apparentlymart/miniclock/parts.txt

RTC:
http://www.digikey.com/product-detail/en/DS3231MZ%2B/DS3231MZ%2B-ND/2754396

LPC812 Microcontroller:
http://www.digikey.com/product-detail/en/LPC812M101JD20FP/568-10435-5-ND/4368883

Right-angle header (for FTDI serial cable):
http://www.digikey.com/product-detail/en/0901210126/WM8100-ND/760815

Square 1.2" LED matrix:
http://www.adafruit.com/products/1819

LED Matrix Driver
http://www.digikey.com/product-detail/en/MAX6960AMH%2BD/MAX6960AMH%2BD-ND/1513156

3.3V voltage regulator
http://www.digikey.com/product-detail/en/LD1117S33TR/497-1242-1-ND/586242

6 Buttons:
http://www.digikey.com/product-detail/en/FSM4JSMATR/450-1759-2-ND/529675

UWX1V470MCL1GB capacitor:
http://www.digikey.com/product-detail/en/UWX1V470MCL1GB/493-2120-1-ND/590095

8MHz oscillator:
http://www.digikey.com/product-detail/en/SG-636PCE%208.0000MC0:ROHS/SER2815CT-ND/1532625
