apparentlymart/miniclock/displayboard/displayboard.kicad_pcb

## KiCad design displayboard/displayboard.kicad_pcb (2016-01-31)

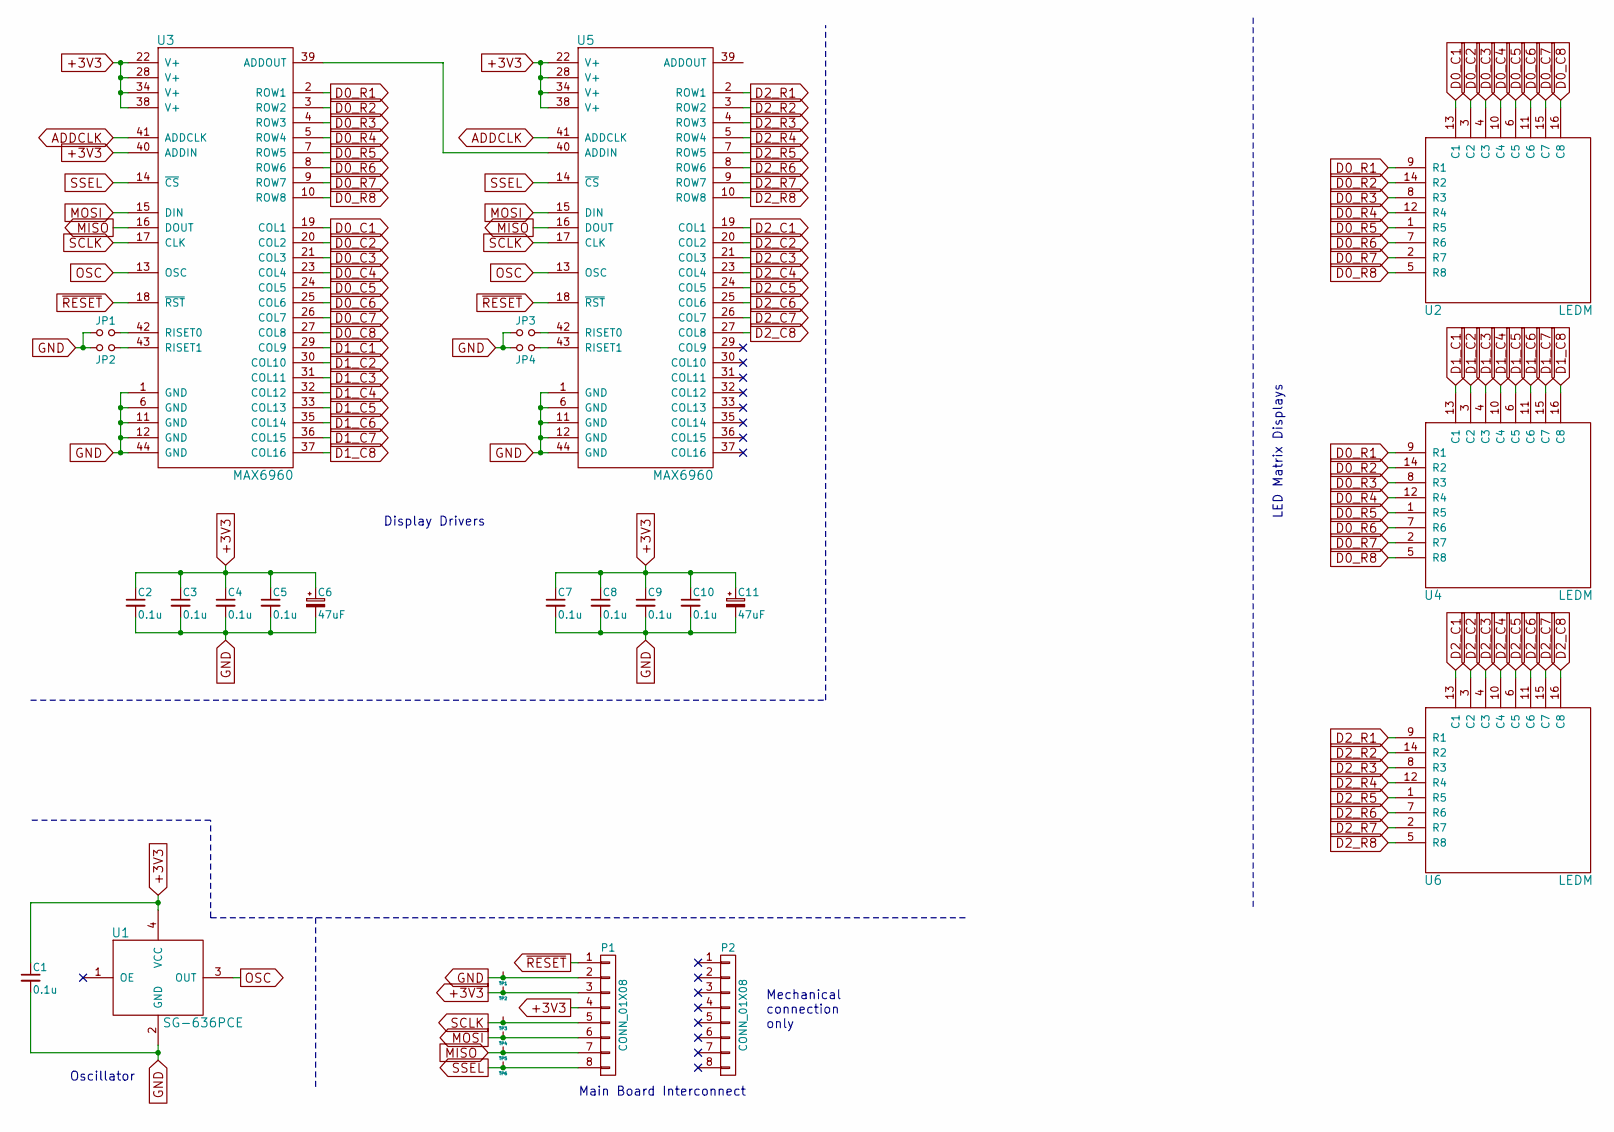
[picture p1: schematic displayboard.sch]

Parts:
C1, C2, C3, C4, C5, C7, C8, C9, C10: 0.1u; 0805
C6, C11: 47uF; UWX1V470MCL1GB
JP1, JP2, JP3, JP4: Jumper_NO_Small; 0805
P1, P2: CONN_01X08; Pin_Header_Straight_1x08
TP1, TP2, TP3, TP4, TP5, TP6: TESTPOINT
U1: SG-636PCE
U2, U4, U6: LEDM; KWM-R30881CUYB
U3, U5: MAX6960

Connections:
+3V3: C1.1, C2.1, C3.1, C4.1, C5.1, C6.1, C7.1, C8.1, C9.1, C10.1, C11.1, P1.3, P1.4, TP2.1, U1.4 (VCC), U3.22 (V+), U3.28 (V+), U3.34 (V+), U3.38 (V+), U3.40 (ADDIN), U5.22 (V+), U5.28 (V+), U5.34 (V+), U5.38 (V+)
ADDCLK: U3.41 (ADDCLK), U5.41 (ADDCLK)
D0_C1: U2.13 (C1), U3.19 (COL1)
D0_C2: U2.3 (C2), U3.20 (COL2)
D0_C3: U2.4 (C3), U3.21 (COL3)
D0_C4: U2.10 (C4), U3.23 (COL4)
D0_C5: U2.6 (C5), U3.24 (COL5)
D0_C6: U2.11 (C6), U3.25 (COL6)
D0_C7: U2.15 (C7), U3.26 (COL7)
D0_C8: U2.16 (C8), U3.27 (COL8)
D0_R1: U2.9 (R1), U3.2 (ROW1), U4.9 (R1)
D0_R2: U2.14 (R2), U3.3 (ROW2), U4.14 (R2)
D0_R3: U2.8 (R3), U3.4 (ROW3), U4.8 (R3)
D0_R4: U2.12 (R4), U3.5 (ROW4), U4.12 (R4)
D0_R5: U2.1 (R5), U3.7 (ROW5), U4.1 (R5)
D0_R6: U2.7 (R6), U3.8 (ROW6), U4.7 (R6)
D0_R7: U2.2 (R7), U3.9 (ROW7), U4.2 (R7)
D0_R8: U2.5 (R8), U3.10 (ROW8), U4.5 (R8)
D1_C1: U3.29 (COL9), U4.13 (C1)
D1_C2: U3.30 (COL10), U4.3 (C2)
D1_C3: U3.31 (COL11), U4.4 (C3)
D1_C4: U3.32 (COL12), U4.10 (C4)
D1_C5: U3.33 (COL13), U4.6 (C5)
D1_C6: U3.35 (COL14), U4.11 (C6)
D1_C7: U3.36 (COL15), U4.15 (C7)
D1_C8: U3.37 (COL16), U4.16 (C8)
D2_C1: U5.19 (COL1), U6.13 (C1)
D2_C2: U5.20 (COL2), U6.3 (C2)
D2_C3: U5.21 (COL3), U6.4 (C3)
D2_C4: U5.23 (COL4), U6.10 (C4)
D2_C5: U5.24 (COL5), U6.6 (C5)
D2_C6: U5.25 (COL6), U6.11 (C6)
D2_C7: U5.26 (COL7), U6.15 (C7)
D2_C8: U5.27 (COL8), U6.16 (C8)
D2_R1: U5.2 (ROW1), U6.9 (R1)
D2_R2: U5.3 (ROW2), U6.14 (R2)
D2_R3: U5.4 (ROW3), U6.8 (R3)
D2_R4: U5.5 (ROW4), U6.12 (R4)
D2_R5: U5.7 (ROW5), U6.1 (R5)
D2_R6: U5.8 (ROW6), U6.7 (R6)
D2_R7: U5.9 (ROW7), U6.2 (R7)
D2_R8: U5.10 (ROW8), U6.5 (R8)
GND: C1.2, C2.2, C3.2, C4.2, C5.2, C6.2, C7.2, C8.2, C9.2, C10.2, C11.2, JP1.1, JP2.2, JP3.1, JP4.2, P1.2, TP1.1, U1.2 (GND), U3.1 (GND), U3.6 (GND), U3.11 (GND), U3.12 (GND), U3.44 (GND), U5.1 (GND), U5.6 (GND), U5.11 (GND), U5.12 (GND), U5.44 (GND)
MISO: P1.7, TP5.1, U3.16 (DOUT), U5.16 (DOUT)
MOSI: P1.6, TP4.1, U3.15 (DIN), U5.15 (DIN)
unnamed: JP1.2, U3.42 (RISET0)
unnamed: JP2.1, U3.43 (RISET1)
unnamed: JP3.2, U5.42 (RISET0)
unnamed: JP4.1, U5.43 (RISET1)
unnamed: U3.39 (ADDOUT), U5.40 (ADDIN)
OSC: U1.3 (OUT), U3.13 (OSC), U5.13 (OSC)
SCLK: P1.5, TP3.1, U3.17 (CLK), U5.17 (CLK)
SSEL: P1.8, TP6.1, U3.14 (~CS), U5.14 (~CS)
~RESET: P1.1, U3.18 (~RST), U5.18 (~RST)

Notes on the sheet:
Mechanical connection only
Main Board Interconnect
Oscillator
LED Matrix Displays
Display Drivers

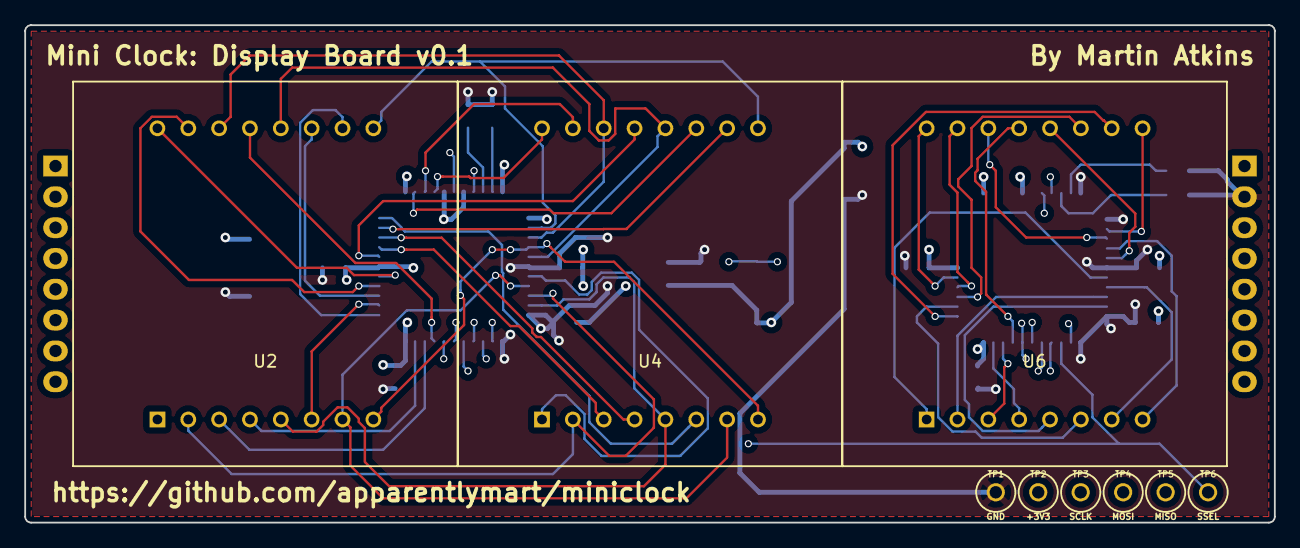
[picture p2: board displayboard.kicad_pcb from above]

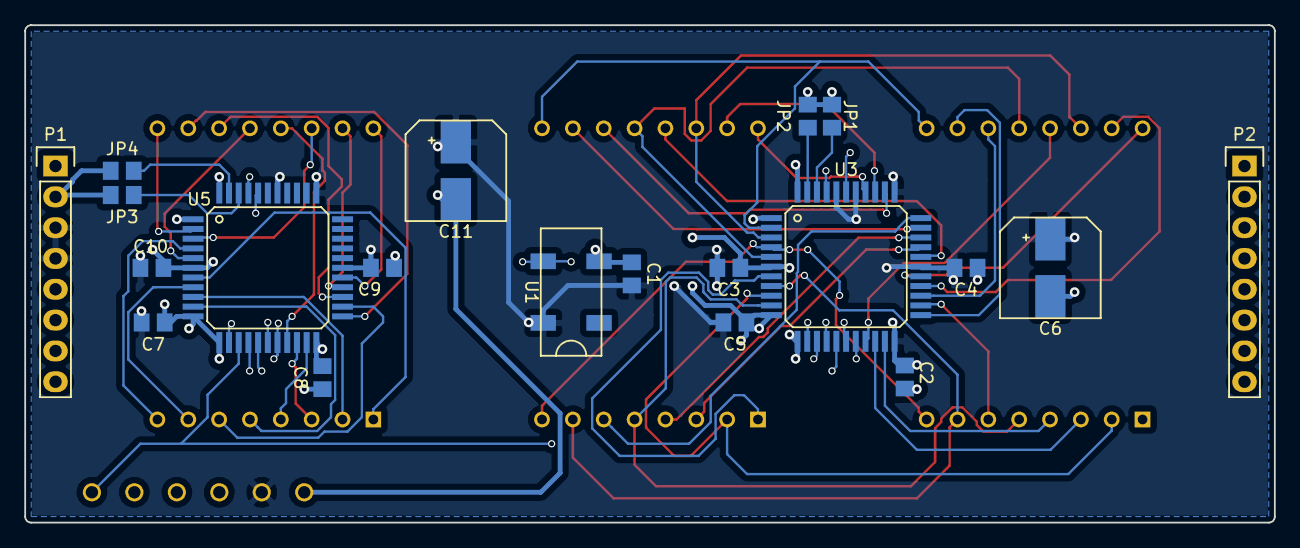
[picture p3: board displayboard.kicad_pcb from below]

Board: 4 copper layers, 103.0 x 41.0 mm, 29 parts (20 on the bottom side), 54 nets.
