apparentlymart/miniclock/mainboard/mainboard.kicad_pcb

## KiCad design mainboard/mainboard.kicad_pcb (2015-09-11)

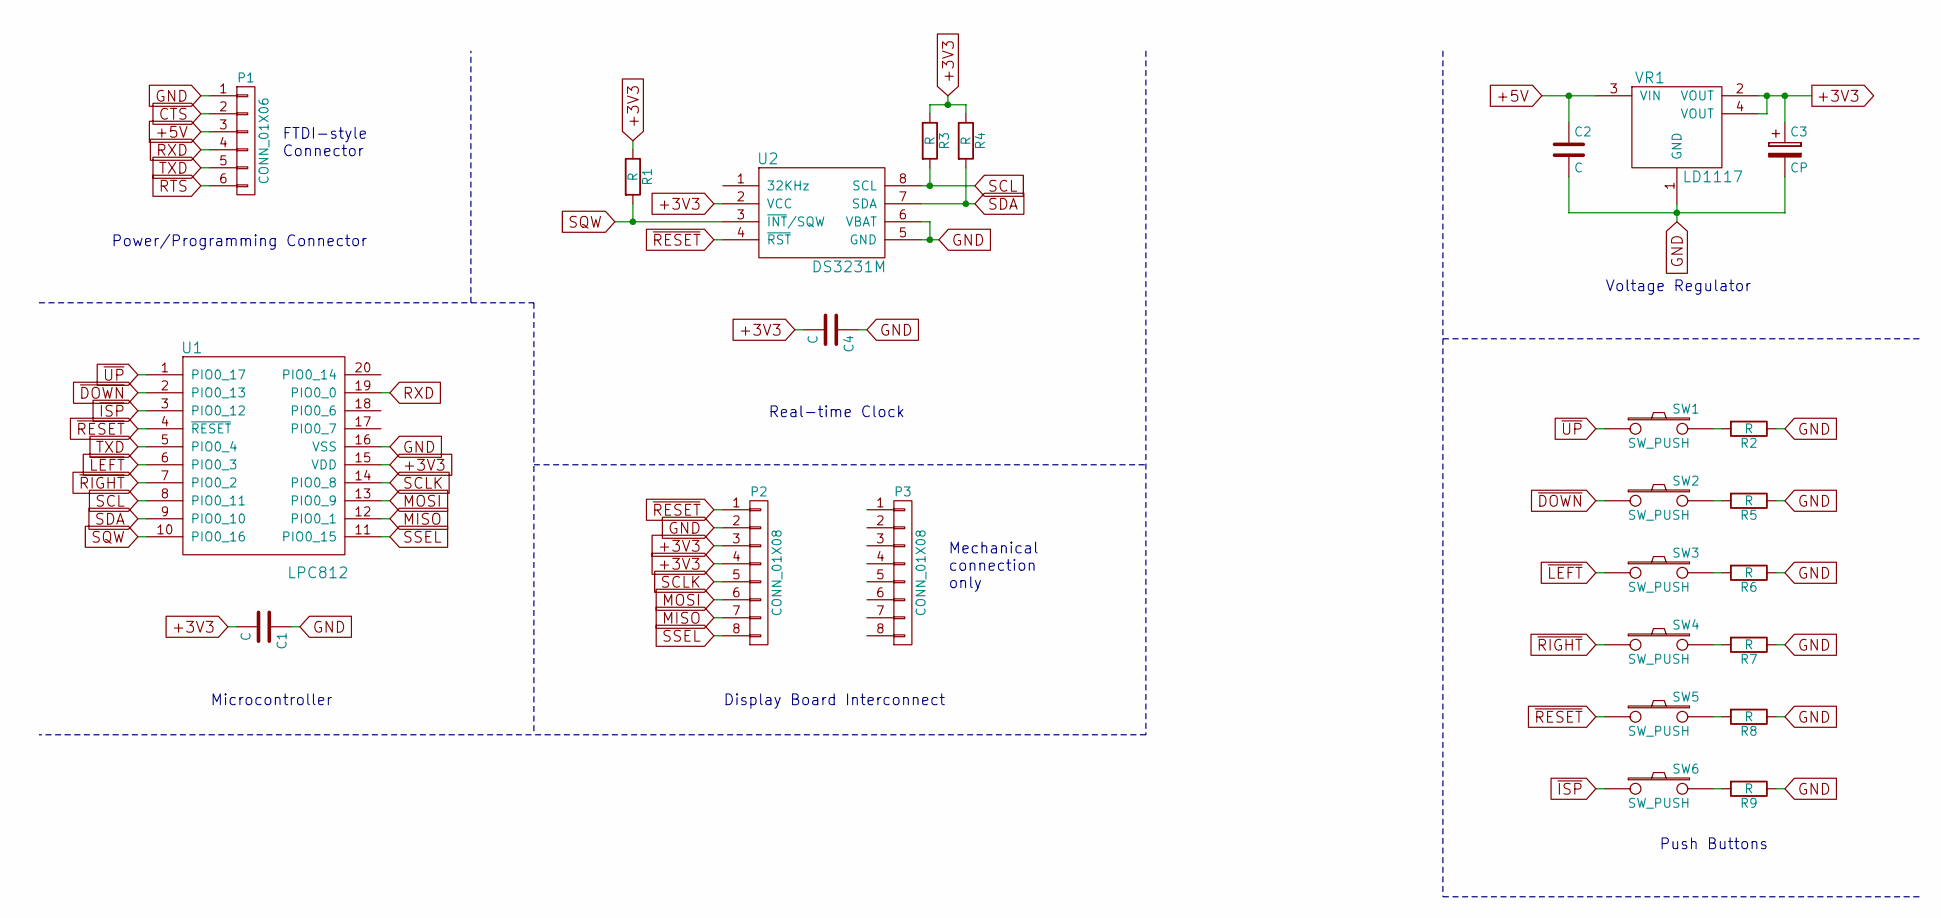
[picture p4: schematic mainboard.sch]

Parts:
C1, C2, C4: C; C_0805_HandSoldering
C3: CP; CPOL_SMD_6.3mm
P1: CONN_01X06; Pin_Header_Straight_1x06
P2, P3: CONN_01X08; Pin_Header_Straight_1x08
R1, R2, R3, R4, R5, R6, R7, R8, R9: R; R_0805_HandSoldering
SW1, SW2, SW3, SW4, SW5, SW6: SW_PUSH; PUSHSWITCH
U1: LPC812; SOIC-20_7.5x12.8mm_Pitch1.27mm
U2: DS3231M; SOIC-8_3.9x4.9mm_Pitch1.27mm
VR1: LD1117; SOT223

Connections:
+3V3: C1.2, C3.1, C4.2, P2.3, P2.4, R1.1, R3.1, R4.1, U1.15 (VDD), U2.2 (VCC), VR1.2 (VOUT), VR1.4 (VOUT)
+5V: C2.1, P1.3, VR1.3 (VIN)
CTS: P1.2
GND: C1.1, C2.2, C3.2, C4.1, P1.1, P2.2, R2.1, R5.1, R6.1, R7.1, R8.1, R9.1, U1.16 (VSS), U2.5 (GND), U2.6 (VBAT), VR1.1 (GND)
MISO: P2.7, U1.12 (PIO0_1)
MOSI: P2.6, U1.13 (PIO0_9)
unnamed: R2.2, SW1.2
unnamed: R5.2, SW2.2
unnamed: R6.2, SW3.2
unnamed: R7.2, SW4.2
unnamed: R8.2, SW5.2
unnamed: R9.2, SW6.2
RTS: P1.6
RXD: P1.4, U1.19 (PIO0_0)
SCL: R3.2, U1.8 (PIO0_11), U2.8 (SCL)
SCLK: P2.5, U1.14 (PIO0_8)
SDA: R4.2, U1.9 (PIO0_10), U2.7 (SDA)
SQW: R1.2, U1.10 (PIO0_16), U2.3 (~INT~/SQW)
SSEL: P2.8, U1.11 (PIO0_15)
TXD: P1.5, U1.5 (PIO0_4)
~DOWN: SW2.1, U1.2 (PIO0_13)
~ISP: SW6.1, U1.3 (PIO0_12)
~LEFT: SW3.1, U1.6 (PIO0_3)
~RESET: P2.1, SW5.1, U1.4 (~RESET), U2.4 (~RST)
~RIGHT: SW4.1, U1.7 (PIO0_2)
~UP: SW1.1, U1.1 (PIO0_17)

Notes on the sheet:
FTDI-style Connector
Microcontroller
Real-time Clock
Voltage Regulator
Power/Programming Connector
Mechanical connection only
Display Board Interconnect
Push Buttons

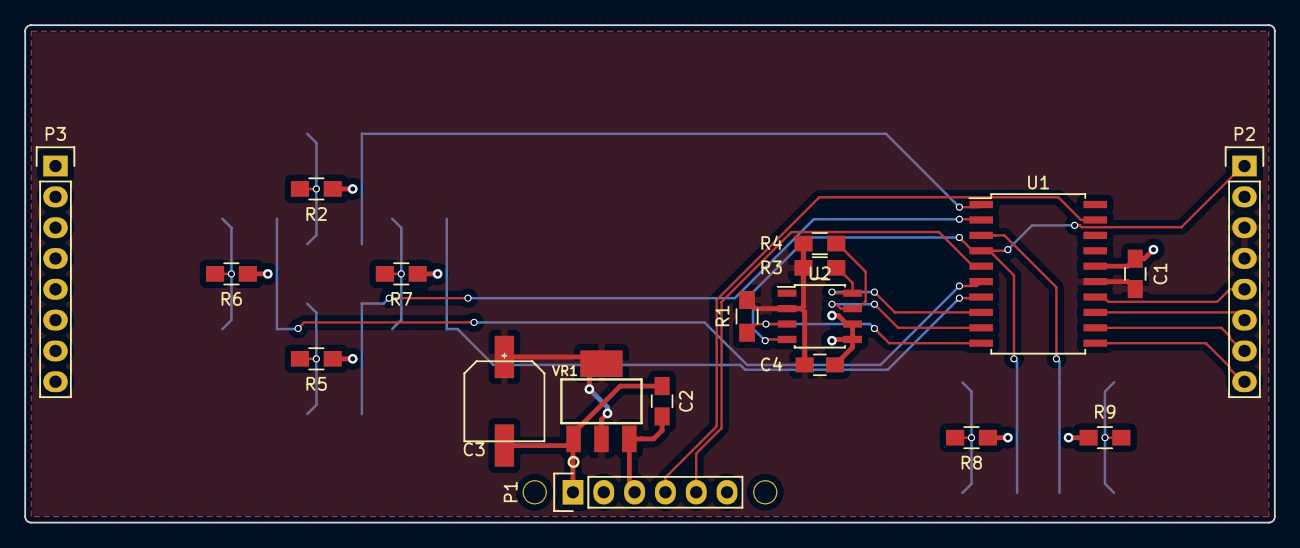
[picture p5: board mainboard.kicad_pcb from above]

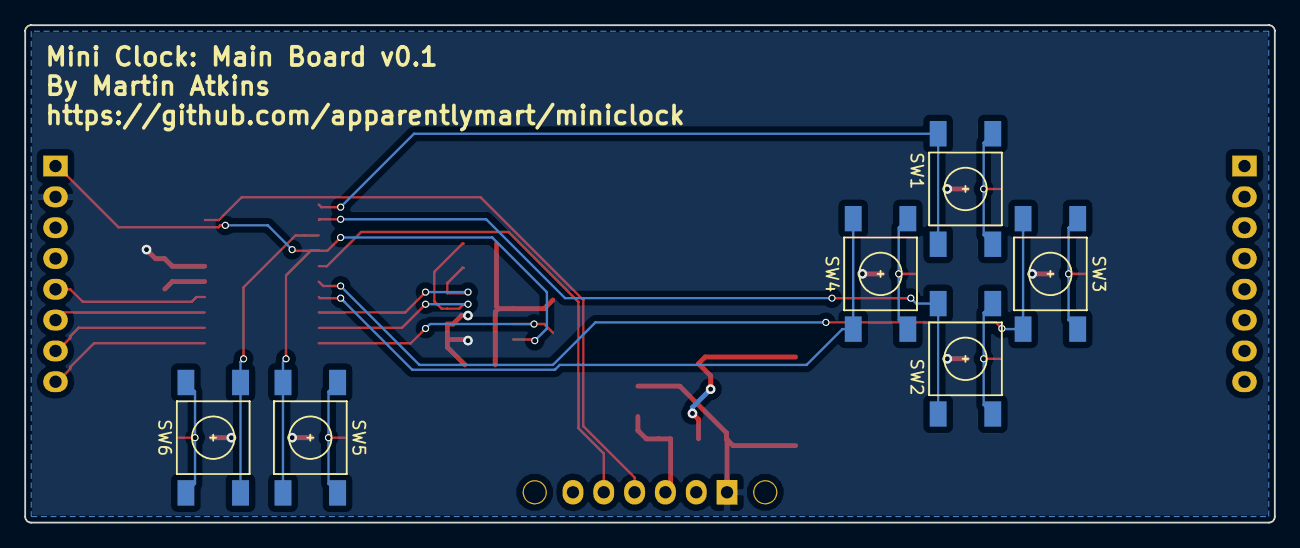
[picture p6: board mainboard.kicad_pcb from below]

Board: 2 copper layers, 103.0 x 41.0 mm, 25 parts (6 on the bottom side), 24 nets.
