apparentlymart/miniclock/firmware/display.c

#include "scheduler.h"
#include "serial.h"
#include "buttons.h"
#include "ui.h"
#include "digits.h"
#include "display_states.h"
#include "clock.h"
#include "spi.h"
#include "display.h"

int anim_active = 0;
sched_list_head transition_tasks;
sched_task *active_transition_task = 0;

// During animation, the first index of this array points to either
// the topmost or the leftmost state, depending on which direction we're
// animating in, with the second index pointing to the bottom or right
// state. When we're not showing two states on-screen, only the first
// index is significant.
ui_state display_states[2] = {UI_BEGIN, UI_BEGIN};
char offset_amt;
char offset_target;
unsigned char offset_dir = 'h';

sched_task anim_dispatch_task;
sched_task anim_task;
void *anim_task_pos;

sched_task time_change_task;

static inline void display_render_row(unsigned char data) {
    spi_tx_8(data);
}

void display_render_horiz(void) {
    // For Horiz, we visit rows in the first state first,
    // and then rows in the second state, until we've
    // filled the screen.
    int elem_row = 0;
    int state_row = 0;
    int screen_row = 0;
    int state_idx = 0;
    int skipped_rows = 0;

    // Reset the display data offset to the beginning of memory
    spi_tx_16(0x09 << 8);
    spi_tx_16(0x0a << 8);

    display_elem *elems = display_elems_for_state(display_states[0]);
    while (1) {
        if (state_row == 24 || screen_row == 24 || ! elems->impl) {
            // If we're still on the first state, we must complete it
            // with blank rows before moving on to the second state.
            if (state_idx == 0) {
                while (state_row < 24 && screen_row < 24) {
                    display_render_row(0);
                    state_row++;
                    screen_row++;
                }
                if (screen_row < 24) {
                    state_idx++;
                    state_row = 0;
                    elems = display_elems_for_state(display_states[1]);
                }
                else {
                    break;
                }
            }
            else {
                // If we're already on the second state then we'll
                // just complete the screen and then we're done.
                while (screen_row < 24) {
                    display_render_row(0);
                    screen_row++;
                }
                break;
            }
        }
        const unsigned char *data_p = elems->impl(elems->arg, elem_row);
        if (! data_p) {
            elem_row = 0;
            elems++;
            continue;
        }

        if (skipped_rows < offset_amt) {
            elem_row++;
            state_row++;
            skipped_rows++;
            // but not screen_row, because we didn't actually
            // render anything.
            continue;
        }

        if (elems->blink && clock_time.half_second) {
            // For blinking elements, render blank if we're in
            // the second half of a second.
            display_render_row(0b00000000);
        }
        else {
            display_render_row(*data_p);
        }

        elem_row++;
        screen_row++;
        state_row++;
    }
}

void display_render_vert(void) {
    // For vert, we visit both states concurrently and then shift their
    // pixel data about to make them render one on top of the other.

    // Reset the display data offset to the beginning of memory
    spi_tx_16(0x09 << 8);
    spi_tx_16(0x0a << 8);

    // Keep track of where we are in the elems of both states.
    int elem_rows[2] = {0, 0};
    display_elem *elems[2] = {
        display_elems_for_state(display_states[0]),
        display_elems_for_state(display_states[1]),
    };
    unsigned char data[2] = {0, 0};

    for (int screen_row = 0; screen_row < 24; screen_row++) {
        for (int state_idx = 0; state_idx < 2; state_idx++) {
            while (1) {
                if (elems[state_idx]->impl) {
                    const unsigned char *data_p = elems[state_idx]->impl(
                        elems[state_idx]->arg, elem_rows[state_idx]
                    );

                    if (data_p) {
                        if (elems[state_idx]->blink && clock_time.half_second) {
                            // For blinking elements, render blank if we're in
                            // the second half of a second.
                            data[state_idx] = 0b00000000;
                        }
                        else {
                            data[state_idx] = *data_p;
                        }
                        elem_rows[state_idx]++;
                        break;
                    }

                    // Try the next element, then.
                    elem_rows[state_idx] = 0;
                    elems[state_idx]++;
                }
                else {
                    // We ran out of elements for this state, so
                    // we'll just fill the rest of the screen with
                    // blanks.
                    data[state_idx] = 0b00000000;
                    break;
                }
            }
        }
        unsigned char merged_data = (
            data[0] >> offset_amt |
            data[1] << (8 - offset_amt)
        );
        display_render_row(merged_data);
    }

}

inline void display_render(void) {
    switch (offset_dir) {
    case 'h':
        display_render_horiz();
        break;
    case 'v':
        display_render_vert();
        break;
    default:
        uart_println("Invalid offset direction");
    }
}

void anim_offset_task(void) {
    TASK_START_EXT(anim_task, anim_task_pos);

    while (1) {
        display_render();
        TASK_AWAIT_EXT_RAW(anim_task_pos, task_sleep(&anim_task, 10));
        if (offset_target < offset_amt) {
            offset_amt--;
        }
        else if (offset_target > offset_amt) {
            offset_amt++;
        }
        if (offset_target == offset_amt) {
            break;
        }
    }

    // Always end in a consistent state.
    offset_amt = 0;
    offset_dir = 'h';
    // If we were moving away from zero then we actually want
    // to land on the second state, so we need to swap them now.
    if (offset_target != 0) {
        display_states[0] = display_states[1];
        offset_target = 0;
    }
    display_render();

    sched_dequeue_task(&anim_task);
    sched_run_task(&anim_dispatch_task);
}

void anim_elastic_space_task(void) {
    TASK_START_EXT(anim_task, anim_task_pos);

    while (1) {
        display_render();
        TASK_AWAIT_EXT_RAW(anim_task_pos, task_sleep(&anim_task, 10));
        if (offset_target < display_elastic_space_size) {
            display_elastic_space_size--;
        }
        else if (offset_target > display_elastic_space_size) {
            display_elastic_space_size++;
        }
        if (offset_target == display_elastic_space_size) {
            break;
        }
    }

    // Always end in a consistent state.
    display_elastic_space_size = 0;
    // If we were moving away from zero then we actually want
    // to land on the second state, so we need to swap them now.
    if (offset_target != 0) {
        display_states[0] = display_states[1];
        offset_target = 0;
    }
    display_render();

    sched_dequeue_task(&anim_task);
    sched_run_task(&anim_dispatch_task);
}

void anim_dispatch_task_impl(void) {

    // This task impl expects to be called only when either there is no
    // active transition, or when the transition is over. We distinguish
    // these cases by whether active_transition_task is set.
    if (active_transition_task) {
        // The transition is complete, so we'll schedule the task
        // to be run on the next loop iteration.
        sched_run_task(active_transition_task);
        active_transition_task = 0;
    }

    // Is there a new transition waiting in the queue?
    if (transition_tasks.next != &transition_tasks) {
        sched_task *task = (sched_task*)transition_tasks.next;
        display_transition_task *trans_task = (display_transition_task*)task;
        // Take the task out of the pending queue.
        sched_dequeue_task(task);
        active_transition_task = task;

        if (trans_task->old_state >= UI_SET_HOUR && trans_task->new_state >= UI_SET_HOUR) {
            // If we're transitioning between the states for setting different
            // components of the time then we won't animate at all, since
            // we're just moving the selection between on-screen elements.
            offset_dir = 'h';
            offset_amt = 0;
            offset_target = 0;
            display_states[0] = trans_task->new_state;
            display_states[1] = trans_task->new_state;
            anim_task.impl = anim_offset_task;
        }
        else if (trans_task->old_state == UI_TIME_HM && trans_task->new_state == UI_TIME_MS) {
            display_elastic_space_size = 12;
            offset_target = 0;
            display_states[0] = trans_task->new_state;
            display_states[1] = trans_task->new_state;
            anim_task.impl = anim_elastic_space_task;
        }
        else if (trans_task->old_state == UI_TIME_MS && trans_task->new_state == UI_TIME_HM) {
            display_elastic_space_size = 0;
            offset_target = 12;
            display_states[0] = trans_task->old_state;
            display_states[1] = trans_task->new_state;
            anim_task.impl = anim_elastic_space_task;
        }
        else if (trans_task->buttons == BUTTON_RIGHT) {
            offset_dir = 'h';
            offset_amt = 22;
            offset_target = 0;
            display_states[0] = trans_task->new_state;
            display_states[1] = trans_task->old_state;
            anim_task.impl = anim_offset_task;
        }
        else if (trans_task->buttons == BUTTON_LEFT) {
            offset_dir = 'h';
            offset_amt = 0;
            offset_target = 23;
            display_states[0] = trans_task->old_state;
            display_states[1] = trans_task->new_state;
            anim_task.impl = anim_offset_task;
        }
        else if (trans_task->buttons == BUTTON_UP) {
            offset_dir = 'v';
            offset_amt = 0;
            offset_target = 7;
            display_states[0] = trans_task->old_state;
            display_states[1] = trans_task->new_state;
            anim_task.impl = anim_offset_task;
        }
        else if (trans_task->buttons == BUTTON_DOWN) {
            offset_dir = 'v';
            offset_amt = 7;
            offset_target = 0;
            display_states[0] = trans_task->new_state;
            display_states[1] = trans_task->old_state;
            anim_task.impl = anim_offset_task;
        }
        else {
            // By default we'll use the anim_offset_task but give
            // it no work to do, so we'll just instantly transition
            // to the new state. This should never happen in practice
            // since one of the above rules should always apply.
            offset_dir = 'h';
            offset_amt = 0;
            offset_target = 0;
            display_states[0] = trans_task->new_state;
            display_states[1] = trans_task->new_state;
            anim_task.impl = anim_offset_task;
        }

        anim_task_pos = 0;
        // Call the task implementation to let it initialize
        // and schedule itself.
        anim_task.impl();
    }
    else {
        // No longer any animations active.
        anim_active = 0;
    }

    // Always dequeue after a run. If we started an animation above
    // then it will queue us back again when it ends, so we'll get
    // an opportunity to start a new animation.
    sched_dequeue_task(&anim_dispatch_task);
}

static void time_change_task_impl(void) {
    TASK_START(time_change_task_impl);

    while (1) {
        CLOCK_AWAIT_CHANGE();
        display_render();
    }
}

void display_init(void) {
    spi_init();

    // Initialize the display
    spi_tx_16(
        (0x0e << 8) | // "Global Driver Devices" register
        1             // 2 devices (1 "extra" device)
    );
    spi_tx_16(
        (0x0f << 8) | // "Global Driver Rows" register
        0             // 1 row (0 "extra" rows)
    );
    spi_tx_16(
        (0x0d << 8) | // "Global Panel Configuration" register
        1             // Disable shutdown mode
    );

    sched_init_task_head(&transition_tasks);
    sched_init_task(&anim_dispatch_task, anim_dispatch_task_impl);
    sched_init_task(&time_change_task, time_change_task_impl);

    // The anim task's implementation will be assigned by the
    // dispatch task, once it decides what kind of animation to use.
    sched_init_task(&anim_task, 0);

    // Immediately schedule our "time change task" so we'll get notified
    // each time the time changes. (every half-second)
    time_change_task_impl();
}

void display_state_change(
    sched_task *task,
    ui_state new_state,
    ui_state old_state,
    button buttons
) {
    display_transition_task *trans_task = (display_transition_task*)task;
    trans_task->new_state = new_state;
    trans_task->old_state = old_state;
    trans_task->buttons = buttons;

    sched_queue_task(&transition_tasks, task);

    if (! anim_active) {
        anim_active = 1;
        sched_run_task(&anim_dispatch_task);
    }
}
