apparentlymart/miniclock/firmware/chars.c

#include "chars.h"

const unsigned char tom_thumb_tall[][4] = {
    { // 32
        0b00000000,
        0b00000000,
        0b00000000,
        0b00000000,
    },
    { // 33 !
        0b00000000,
        0b01011111,
        0b00000000,
        0b00000000,
    },
    { // 34 "
        0b00000011,
        0b00000000,
        0b00000011,
        0b00000000,
    },
    { // 35 #
        0b00111110,
        0b00010100,
        0b00111110,
        0b00000000,
    },
    { // 36 $
        0b00101000,
        0b01111110,
        0b00010100,
        0b00000000,
    },
    { // 37 %
        0b01100001,
        0b00011100,
        0b01000011,
        0b00000000,
    },
    { // 38 &
        0b00111110,
        0b01011110,
        0b01110000,
        0b00000000,
    },
    { // 39 '
        0b00000000,
        0b00000011,
        0b00000000,
        0b00000000,
    },
    { // 40 (
        0b00000000,
        0b01111110,
        0b10000001,
        0b00000000,
    },
    { // 41 )
        0b10000001,
        0b01111110,
        0b00000000,
        0b00000000,
    },
    { // 42 *
        0b00010101,
        0b00001110,
        0b00010101,
        0b00000000,
    },
    { // 43 +
        0b00001000,
        0b00011100,
        0b00001000,
        0b00000000,
    },
    { // 44 ,
        0b10000000,
        0b01000000,
        0b00000000,
        0b00000000,
    },
    { // 45 -
        0b00001000,
        0b00001000,
        0b00001000,
        0b00000000,
    },
    { // 46 .
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
        0b00111000,
        0b01000000,
        0b01111000,
        0b00000000,
    },
    { // 118 v
        0b00111000,
        0b01000000,
        0b00111000,
        0b00000000,
    },
    { // 119 w
        0b01111000,
        0b01110000,
        0b01111000,
        0b00000000,
    },
    { // 120 x
        0b01001000,
        0b00110000,
        0b01001000,
        0b00000000,
    },
    { // 121 y
        0b00011000,
        0b10100000,
        0b01111000,
        0b00000000,
    },
    { // 122 z
        0b01101000,
        0b01111000,
        0b01011000,
        0b00000000,
    },
    { // 123 {
        0b00011000,
        0b11100111,
        0b10000001,
        0b00000000,
    },
    { // 124 |
        0b00000000,
        0b01110111,
        0b00000000,
        0b00000000,
    },
    { // 125 }
        0b10000001,
        0b11100111,
        0b00011000,
        0b00000000,
    },
    { // 126 ~
        0b00000010,
        0b00000011,
        0b00000001,
        0b00000000,
    }
};


const unsigned char* chars_row(int val, int row) {
    if (val < 32 || val > 126) {
        return 0;
    }
    val -= 32;
    return row < 4 ? ((const char *)tom_thumb_tall + (val * 4) + row) : 0;
}
