apparentlymart/miniclock/firmware/serial.c

#include <stdint.h>
#include "lpc812.h"
#include "serial.h"

static uart_buffer rx_buffer;

void UART0_isr(void);

void uart_init() {
    // Put the UART in reset mode.
    SYSCON_PRESETCTRL &= ~BIT3;

    rx_buffer.count = 0;
    rx_buffer.head = 0;
    rx_buffer.tail = 0;

    // Enable USART0 clock
    SYSCON_SYSAHBCLKCTRL |= BIT14;

    // Take the UART out of reset mode,
    SYSCON_PRESETCTRL |= BIT3;

    // Disable UART0 while we configure it.
    USART0_CFG = 0;

    // Enable USART0 IRQs
    NVIC_ISER0 |= BIT3;

    // Map the USART0 pins to match the ISP pins.
    PINENABLE0 |= BIT0;
    PINASSIGN0 &= 0xffff0000;
    PINASSIGN0 |= 4; // TXD on PIO0_4
    PINASSIGN0 |= 0; // RXD on PIO0_0

    // 115200 baud
    SYSCON_UARTCLKDIV = 1;
    USART0_BRG = 31;

    SYSCON_UARTFRGDIV = 0xff;
    SYSCON_UARTFRGMULT = 4;

    // Enable RX interrupt
    USART0_INTENSET = BIT0;
    USART0_CTL = 0;

    // 8 data bits, 1 stop bit, no parity bit
    USART0_CFG = 0b00000101;
}

void UART0_isr(void) {
    int source = USART0_INTSTAT;
    // If it's the RX interrupt
    if (source & BIT0) {
        uart_buffer_put(&rx_buffer, USART0_RXDAT);
    }
}

void uart_buffer_put(uart_buffer *sbuf, char c) {
    if (sbuf->count < SBUFSIZE) {
        disable_interrupts();
        sbuf->count++;
        sbuf->buffer[sbuf->head] = c;
        sbuf->head = (sbuf->head + 1) % SBUFSIZE;
        enable_interrupts();
    }
}

char uart_buffer_get(uart_buffer *sbuf) {
    char c = 0;
    if (sbuf->count >0 ) {
        disable_interrupts();
        sbuf->count--;
        c = sbuf->buffer[sbuf->tail];
        sbuf->tail = (sbuf->tail+1) % SBUFSIZE;
        enable_interrupts();
    }
    return c;
}

int uart_rx_buffer_count() {
    return rx_buffer.count;
}

void uart_putc(char c) {
    // Poll for the transmitter to become ready
    while ((USART0_STAT & (0x1 << 2)) == 0);

    USART0_TXDAT = c;

    // Poll for the transmitter to return to idle
    while ((USART0_STAT & (0x1 << 3)) == 0);
}

void uart_puts(const char *s) {
    for (; *s; s++) {
        uart_putc(*s);
    }
}

void uart_put_int_hex(unsigned int val) {
    for (int i = 0; i < 8; i++) {
        // Read the top nybble.
        int digit = val >> 28;

        char c;
        if (digit < 0xa) {
            c = '0' + digit;
        }
        else {
            c = ('a' - 0xa) + digit;
        }

        uart_putc(c);

        // Push everything up one nybble.
        val <<= 4;
    }
}

char uart_getc() {
    return uart_buffer_get(&rx_buffer);
}

void uart_println(const char *s) {
    uart_puts(s);
    uart_puts("\r\n");
}

void uart_println_int_hex(const char *s, unsigned int val) {
    uart_puts(s);
    uart_put_int_hex(val);
    uart_puts("\r\n");
}
