apparentlymart/miniclock/(commit log)

2015-02-23 Sketch BOM
2015-02-28 KiCAD project.
2015-02-28 Initial import of schematic, with voltage regulator.
    [diyalarmclock.sch]
2015-02-28 Basic wiring for MCU and RTC.
    Still need to add capacitors to the power inputs.
    [diyalarmclock.sch]
2015-03-28 Start of schematic for the main control board.
    [miniclockmainboard.sch]
2015-03-28 Further work on the main board schematic.
    [miniclockmainboard.sch]
2015-03-28 Add RTC chip, I2C/SPI headers and support bits.
    [miniclockmainboard.sch]
2015-03-28 Complete first rev of the main board schematic.
    [miniclockmainboard.sch]
2015-03-28 Some PCB footprints for the main board.
2015-03-28 Schematic to footprint mappings.
2015-03-28 Main board PCB layout.
    [miniclockmainboard.kicad_pcb]
2015-03-28 Add some silkscreen captions to the rear of the main board.
    [miniclockmainboard.kicad_pcb]
2015-03-29 Shrink the main board width.
    Previous version was slightly too wide for the first prototype's
    enclosure. The new size is much smaller than the available space in the
    enclosure.
    [miniclockmainboard.kicad_pcb]
2015-03-29 Fix up the pad positions on the polarized caps.
    The pads were incorrectly spaced before since the space between the pad
    edges was confused with the space between the centers.
    [miniclockmainboard.kicad_pcb]
2015-09-08 Delete everything so we can start over.
    This project has bitrotted since I last opened it, so rather than trying
    to repair it I'm just going to start over again.
    [diyalarmclock.sch, miniclockmainboard.kicad_pcb, miniclockmainboard.sch]
2015-09-08 Main board schematic.
    This project will ultimately be made from two separate PCBs. The main
    board contains the microcontroller and RTC, while the display board
    (yet to be designed) will contain the display LEDs and their associated
    driver chips. The communication between the two boards is via an SPI bus,
    augmented with a ~RESET line so that the display drivers can reset along
    with everything else.
    [mainboard.kicad_pcb, mainboard.sch]
2015-09-08 Map schematic symbols to footprints.
    [mainboard.sch]
2015-09-08 Mainboard outline
    [mainboard.kicad_pcb]
2015-09-08 Component placement on PCB.
    [mainboard.kicad_pcb]
2015-09-08 Random schematic editor settings.
2015-09-08 DC regulator traces.
    [mainboard.kicad_pcb]
2015-09-08 Button traces.
    [mainboard.kicad_pcb]
2015-09-08 RTC traces.
    [mainboard.kicad_pcb]
2015-09-08 Remaining traces.
    [mainboard.kicad_pcb]
2015-09-08 Connect final missing link.
    (This isn't actually really needed since these things are connected
    internally within the regulator, but this pacifies the KiCad DRC.
    [mainboard.kicad_pcb]
2015-09-08 Using a larger LED matrix now.
    Going bigger because it'll be easier to fit the LED matrix drivers on the
    display board this way. It isn't really necessary for the mainboard to be
    this large except that it ought to match the display board.
2015-10-18 First steps towards a firmware.
    This builds and runs but doesn't quite work yet... the UART seems to be
    running faster than desired, causing every alternating character to be
    missed by the receiving device.
    [init.c, lpc812.h, main.c, serial.c, serial.h]
2015-10-26 Print newline at the end of our message.
2015-10-26 Don't skip alternate characters in uart_puts.
    A bug here was causing s to get incremented twice per loop. This bug was
    introduced by some careless reworking of this code to use a for loop
    instead of a while loop.
    [serial.c]
2015-10-30 Explicitly set the system clock to 60MHz.
    In spite of the earlier comment to the contrary, this was actually already
    the case because that's the boot-time setting. Here we just correct the
    comment and add an explicit configuration to aid in understanding of
    what's going on here.
    [init.c]
2015-10-30 Correctly configure the UART.
    Some mis-reading of the datasheet led to a complete misunderstanding of
    the structure of the USART0_CFG register, causing the UART to be
    configured for 2 stop bits, 7-bit data length and even parity. Despite
    how wrong this was, it ended up generating a bunch of bytes correctly,
    making it hard at first to recognize the problem.
    The new setting is, as the comment originally suggested, 1 stop bit,
    8-bit data length and no parity bit.
    [serial.c]
2015-11-02 Basic prototype of using pin interrupts.
    Still doesn't do anything useful, but this is a reasonable checkpoint
    on the way to having a button driver.
    [init.c, lpc812.h, main.c]
2015-11-06 Blocking I2C driver.
    Will rewrite this to be interrupt-driven later, but this is just a simple
    case to prove that the RTC chip is behaving.
2015-11-06 Sleep and use the RTC's 1Hz square wave to wake up every 0.5s.
    Still just more prototyping, in this case making sure that we can use the
    1Hz SQW pin as an interrupt and sleep between them.
2015-11-06 Start of an interface to the buttons.
2015-11-08 Add some interrupt vectors that were skipped.
    All of the interrupt vectors above 12 were off by three, which explains
    why the GPIO interrupts didn't seem to be working quite right before.
    [init.c]
2015-11-08 Wake-up timer registers.
2015-11-08 Fleshed out scheduler.
    It now basically works and supports timer events. It's using the
    SysTick timer, so we run through the event loop at least once every
    10ms.
    Ideally we would set the timer to occur at the time of the next timer
    in the list, but so far I couldn't find a way to measure the time
    elapsed while the processor is asleep and so waking up every 10ms is
    necessary to keep track of the (approximate) passage of time. Hopefully
    a better solution will present itself later, but this will work for
    now.
2015-11-08 Timer task list should be in order of wake_time.
    Previously I cheated and just appended each new task to the end of the
    list, since I knew the test code only had one task at a time. This is the
    more correct implementation, inserting the new task into the appropriate
    place in the list.
    [scheduler.c]
2015-11-08 Use macros to make task implementations less verbose.
    This borrows from Adam Dunkels' protothreads, but using the GCC computed
    goto extension to avoid the limitations around using switch statements.
    [main.c, scheduler.h]
2015-11-08 Button input interface.
    Interacts with the scheduler to allow tasks to do blocking reads of the
    direction buttons, with them becoming runnable again only after we get
    a debounced press down.
    This initial implementation has a bug where pressing a second button when
    one is already pressed will cause a spurious press event when one of the
    buttons is released. This can be refined later by keeping track of the
    previous state so that only true differences are reported.
    [buttons.c, buttons.h, init.c, main.c, scheduler.c, scheduler.h]
2015-11-08 uart_println_int_hex wrapper to print a captioned integer.
2015-11-09 UI state machine.
    Handles the transitions between the UI states when the directional buttons
    are pressed.
2015-11-09 Start of display-handling code.
    The display module is responsible for rendering something appropriate
    on the screen for the current state, and creating animated transitions
    between states.
2015-11-09 Don't lock up when multiple timer tasks are outstanding.
    This loop was broken in that it would lock up if it needed to insert
    a new task after an existing task, because the loop iteration expression
    was incorrect.
    [scheduler.c]
2015-11-09 Export the millis count for use in other modules.
2015-11-09 Prototype display driver.
    The display is built from "display elements", which are defined by a
    row generator function and an integer argument to provide to it. Each
    element can generate zero or more display rows (which will actually be
    columns on the final display).
    Eventually each UI state will have its own set of display elements that
    together define what is displayed on-screen in that state. The display
    manager will also eventually be able to show partial renderings of two
    different states on-screen in order to implement the inter-state
    transitions.
    For now, since the "real" display board isn't built yet, we produce a
    simulated version of the display on the UART.
2015-11-14 Generalize the offset animation to work in all directions.
    The previous prototype had a separate-but-largely-identical implementation
    for each movement direction. Here we generalize this to a single
    implementation that just shifts the offset towards a target.
2015-11-14 Select display elements based on state.
    Initially we just show the HH:MM placeholder for the TIME_HM state and
    blank for everything else.
    This has exposed a bug in the horizontal-offset display rendering code
    which needs further investigation.
    [display.c, display.h, display_states.c, display_states.h]
2015-11-14 Keep track of real time and update display each time it changes.
    We actually keep track of time to the half-second so that we can blink
    display elements on and off at 1Hz in synchrony with the RTC's idea
    of seconds.
2015-11-15 Invert the blinking to be visible in the first half of the second.
    [display.c]
2015-11-15 Flip the animation directions.
    Previously the whole-screen transitions went in opposition to the
    direction arrows, as if moving the "camera" over a set of items, while
    the hour-to-second transition was the opposite.
    For consistency, now the animation moves in the direction of the arrow
    pressed, as if the user is moving a "canvas" that all of the UI elements
    are on.
    [display.c]
2015-11-15 UI states for setting the time.
    This UI is not actually functional yet, but it shows the right stuff on
    the screen so that it'll work once we get the time-updating functions
    wired up.
2015-11-15 Eliminate the transition debugging output.
    The UART now just produces the emulated display.
2015-11-22 Start of display board design.
    So far just enough to conform to the shape and connector layout of the
    main board.
    [displayboard.kicad_pcb]
2015-11-23 LED matrix schematic symbol.
    [displayboard.sch]
2015-11-23 MAX6960 schematic symbol.
    [displayboard.sch]
2015-11-29 SG-636PCE oscillator schematic symbol.
2015-11-29 Complete schematic.
    [displayboard.sch]
2015-11-29 MAX6960 footprint
2015-11-29 SG-636PCE footprint
2015-11-29 Assorted updates that I didn't properly distinguish.
    [displayboard.sch]
2015-11-29 PCB footprint assignment and floor planning.
    [displayboard.kicad_pcb, displayboard.sch]
2015-11-29 Spinning the chips around trying to find the least-sucky orientation.
    There seems to be no good orientation for these chips vs. the pinout of
    the LED displays.
    [displayboard.kicad_pcb]
2015-11-29 Thin the LED anode/cathode traces.
    They were originally classified as power but the PCB is too crowded to
    give them thick power traces, and the thin signal traces should do well
    enough since we're not going to be drawing more than 20mA per LED anyway.
    [displayboard.kicad_pcb]
2015-11-29 Connect the bulk capacitor.
    [displayboard.kicad_pcb]
2015-12-27 Another attempt at PCB traces.
    This became kinda spaghetti-like but I think it should be okay since none
    of these signals are high-frequency. The power planes got a bit abused for
    some signal routing but hopefully not too much.
    [displayboard.kicad_pcb]
2015-12-27 3D models of some of the components.
    Also flipped the inter-board connection headers since they were on the
    wrong side of the board as far as KiCad is concerned.
    [displayboard.kicad_pcb]
2015-12-27 Label the test points.
    [displayboard.kicad_pcb]
2015-12-28 Shrink solder mask clearance on the QFP chips.
    Their pin pitch is too low for the default clearance, causing there to be
    no solder mask between the pins at all. This shrinks it so that there is
    at least a small amount of clearance.
    [displayboard.kicad_pcb]
2015-12-28 View all the layers.
    [displayboard.kicad_pcb]
2016-01-31 Latest PCB changes
    [displayboard.kicad_pcb]
2016-01-31 Note on which capacitors and oscillators are being used
2016-02-01 Not-yet-working SPI driver
    There is something missing from this but I've not yet figured out what.
    [lpc812.h, main.c, spi.c, spi.h]
2016-02-01 Stop using GPIO 1 and 15 as debug signals
    We're now going to use them for SPI.
2016-02-01 Software SPI implementation
    Couldn't quite figure out why the hardware SPI wasn't playing ball so I
    just wrote a bit-bang software implementation for now. Will probably come
    back and try to get hardware SPI working again once the rest is
    implemented.
2016-02-01 init.c depends on uart_println for exception handling
2016-02-01 Render display to LED matrices rather than UART
    Now that we have working SPI we can talk to the display drivers and
    actually render the display on the display.
